askkostya/RemoteSwitch/schematic/MainModule30pin.JPG

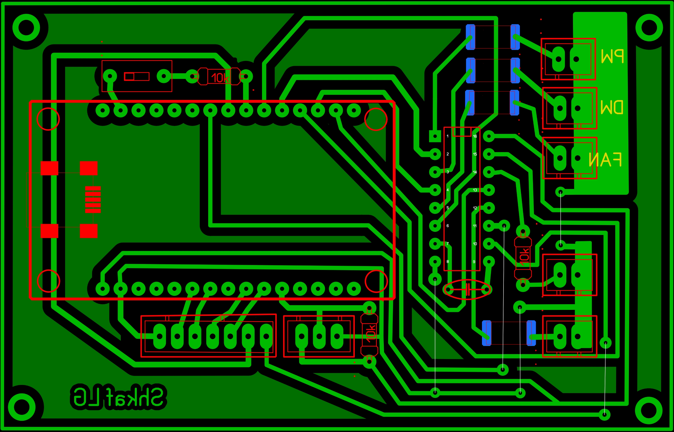
schematic/MainModule30pin.JPG
