askkostya/RemoteSwitch/schematic/OptronBoard.JPG

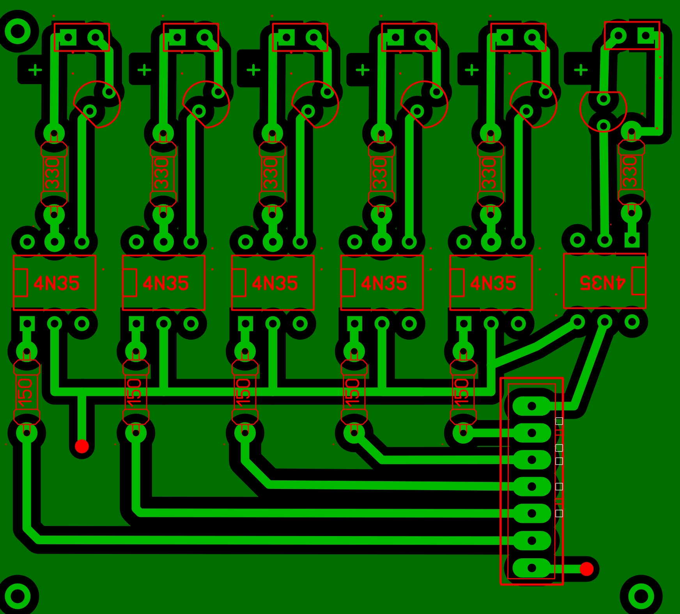
schematic/OptronBoard.JPG
