askkostya/RemoteSwitch/schematic/Schematic_ShkafLG_MainModule.JPG.JPG

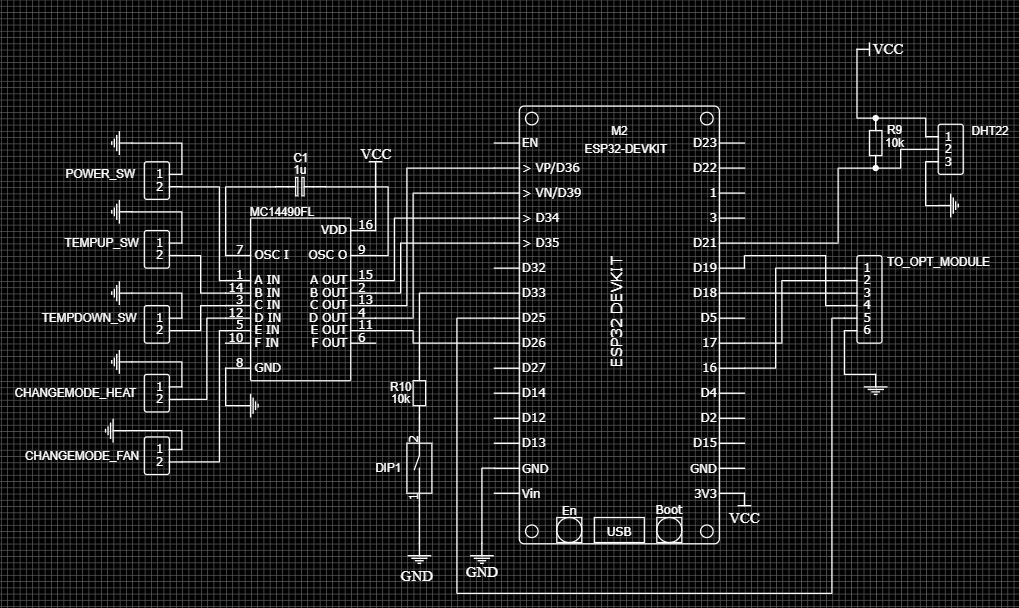
schematic/Schematic_ShkafLG_MainModule.JPG.JPG
