askkostya/RemoteSwitch/schematic/Schematic_ShkafLG_OptronModule.JPG

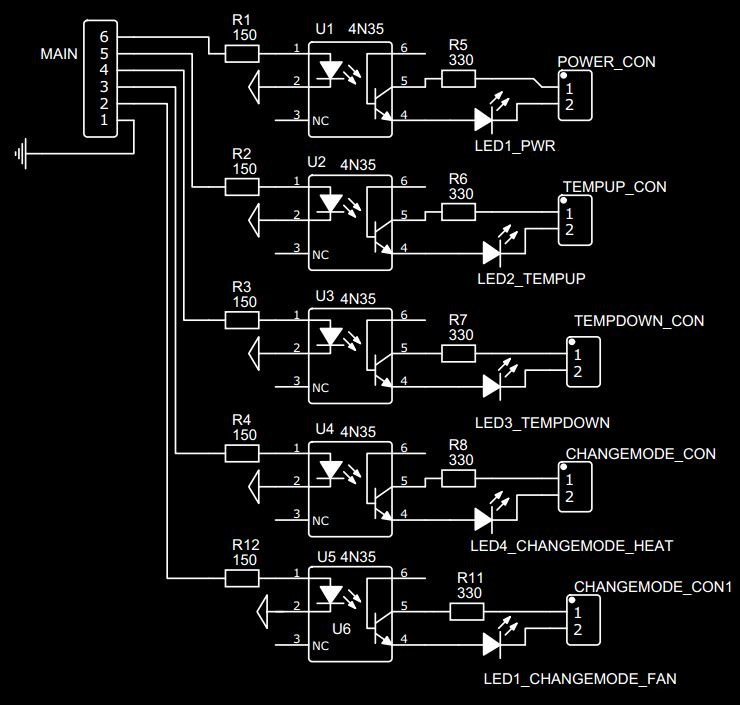
schematic/Schematic_ShkafLG_OptronModule.JPG
