askkostya/RemoteSwitch/(list of files, drawings)

Other design files:
schematic/pcb.lay6
