askkostya/RemoteSwitch/(commit log)

2020-04-09 Add files via upload
    Уменьшены значения для корректной работы
    int durationON = 700000
    int durationOFF = 100000
2020-04-23 Плата основного модуля
    [MainModule.lay6]
